AttilaFiel/Heating_Monitor_System/KiCad/HMS_Master/report.txt

Info: Processing symbol 'C1470µF/10V1:Capacitor_THT:CP_Radial_D8.0mm_P3.50mm'.
Info: Processing symbol 'C2100nF/50V1:Capacitor_THT:C_Disc_D3.8mm_W2.6mm_P2.50mm'.
Info: Processing symbol 'F1:Fuse:Fuseholder_Cylinder-5x20mm_Schurter_0031_8201_Horizontal_Open'.
Info: Processing symbol 'Q1:Package_TO_SOT_THT:TO-92_Inline'.
Info: Processing symbol 'R1:Resistor_THT:R_Axial_DIN0207_L6.3mm_D2.5mm_P7.62mm_Horizontal'.
Info: Processing symbol 'R2:Resistor_THT:R_Axial_DIN0207_L6.3mm_D2.5mm_P7.62mm_Horizontal'.
Info: Processing symbol 'R3:Resistor_THT:R_Axial_DIN0207_L6.3mm_D2.5mm_P7.62mm_Horizontal'.
Info: Processing symbol 'U1:HMS_Footprints:ESP32_DEVKITC_32UE'.
Info: Processing symbol 'U9:Connector_PinSocket_2.54mm:PinSocket_1x06_P2.54mm_Vertical'.
Info: Processing symbol 'U11:Connector_PinSocket_2.54mm:PinSocket_1x06_P2.54mm_Vertical'.
Info: Processing symbol 'U14:Connector_JST:JST_PH_B3B-PH-K_1x03_P2.00mm_Vertical'.
Info: Processing symbol 'U3:Connector_PinSocket_2.54mm:PinSocket_1x05_P2.54mm_Vertical'.
Info: Processing symbol 'U15:Connector_JST:JST_PH_B3B-PH-K_1x03_P2.00mm_Vertical'.
Info: Processing symbol 'U16:Connector_JST:JST_PH_B3B-PH-K_1x03_P2.00mm_Vertical'.
Info: Processing symbol 'U17:Connector_JST:JST_PH_B3B-PH-K_1x03_P2.00mm_Vertical'.
Info: Processing symbol 'U18:Connector_JST:JST_PH_B3B-PH-K_1x03_P2.00mm_Vertical'.
Info: Processing symbol 'U19:Connector_JST:JST_PH_B2B-PH-K_1x02_P2.00mm_Vertical'.
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
Error: U3 pad T+ not found in Connector_PinSocket_2.54mm:PinSocket_1x05_P2.54mm_Vertical.
Error: U3 pad T- not found in Connector_PinSocket_2.54mm:PinSocket_1x05_P2.54mm_Vertical.
Error: U9 pad SCL not found in Connector_PinSocket_2.54mm:PinSocket_1x06_P2.54mm_Vertical.
Error: U9 pad SDA not found in Connector_PinSocket_2.54mm:PinSocket_1x06_P2.54mm_Vertical.
Error: U9 pad VCC not found in Connector_PinSocket_2.54mm:PinSocket_1x06_P2.54mm_Vertical.
Error: U9 pad GND not found in Connector_PinSocket_2.54mm:PinSocket_1x06_P2.54mm_Vertical.
Error: U9 pad 32K not found in Connector_PinSocket_2.54mm:PinSocket_1x06_P2.54mm_Vertical.
Error: U9 pad SQW not found in Connector_PinSocket_2.54mm:PinSocket_1x06_P2.54mm_Vertical.
Error: U11 pad CS not found in Connector_PinSocket_2.54mm:PinSocket_1x06_P2.54mm_Vertical.
Error: U11 pad 3v3 not found in Connector_PinSocket_2.54mm:PinSocket_1x06_P2.54mm_Vertical.
Error: U11 pad GND not found in Connector_PinSocket_2.54mm:PinSocket_1x06_P2.54mm_Vertical.
Error: U11 pad MISO not found in Connector_PinSocket_2.54mm:PinSocket_1x06_P2.54mm_Vertical.
Error: U11 pad MOSI not found in Connector_PinSocket_2.54mm:PinSocket_1x06_P2.54mm_Vertical.
Error: U11 pad CLK not found in Connector_PinSocket_2.54mm:PinSocket_1x06_P2.54mm_Vertical.

Info: Total warnings: 55, errors: 55.
