AttilaFiel/Heating_Monitor_System/Documentation/HMS Documentation.docx

# Heating Monitor System (HMS)

# A projekt célja

2 kis gép építése fűtés rendszer megfigyelésére. Nem vezérlés a cél, de nyitva hagyom az opciót ha minden nagyon jól megy. Az eddigi biztos eszközök végeznek mindent.

A két ESP32-nek a mérés, megfigyelés, logolás és biztonsági figyelmeztetés lesz a feladatuk.

# Jelenlegi fűtés rendszer

1 vegyestüzelésű (fával fűtve) és 1 gázkazán van a rendszeren. Mindkettőnek saját keringetője van. Mindkettő előtt és után van egy golyós csap. Egy csap mindig el van zárva, attól függően melyik megy. Ha egyikről át kell állni a másikra akkor legalább az egyik csapot el kell zárni és megnyitni a másikon azt ami el van zárva. Így oldható meg, hogy egyik keringető sem keringeti a vizet a másik kazán rendszerén keresztül.

2 csőtermosztát van.

Az egyik akkor kapcsolja a vegyes tüzelésű kazán keringetőjét amikor be van gyújtva és az előremenő ág elkezd melegedni.

A másik a gázkazán visszatérő ágán van. Ez csak biztonsági feladatot lát el. Ha túlmelegszik a víz akkor lekapcsolja az gázkazán teljes áramellátását, megakadályozva a túlmelegedést, felforrást.

# Project előtti fejlesztés

1-1 golyós szelep felszerelése 230V szervomotorral.

A csőtermosztát úgy lesz bekötve, hogy a vegyestüzelésű kazán előremenő ágán, hogy a beállított hőmérséklet alatt kinyitja a gázkazán szelepét, elzárja a vegyestüzelésű kazán szelepét és áramot ad a gázkazán keringetőjének (a keringető nélkül nem folyik a gáz sem, tehát nem is tud beindulni a gázfűtés a termosztáttól függetlenül).

A beállított hőmérséklet felett kinyitja a vegyestüzelésű kazán szelepét, elzárja a gázkazán szelepét és áramot ad a vegyestüzelésű kazán keringetőjének.

Ennek a célja, hogy automatikusan átálljon gázra a rendszer ha kialudt a tűz és lehűlt a ház.

# ESP32 project

2 db ESP32. Az egyik a monitorozást és logolást végzi a kazánházban. A másik a hálószobában mutatja a mért értékeket.

A két ESP32 vezeték nélkül, wifi hálózaton kommunikál.

Veszély vagy bizonyos mért értékek esetén figyelmeztetést vagy riasztást ad (főleg az éjszakai vegyesről gázra való átállás a kritikus).

Jövőbeli project: icinga vagy nagios szerver az openwrt routeren vagy ubuntu laptopon ami összegyűjti a mért értékeket, logokat. Android appban folyamatos monitorozás.

## HMS-Master (kazánház)

Feladata a csatolt érzékelők olvasása, logolása és kijelzése

### Vezérlő:

1 db ESP32_DEVKITC_32UE https://www.hestore.hu/prod_10049537.html 100.495.37

### Kijelző:

2 db D096-12864-SPI7 kijelző https://www.hestore.hu/prod_10047949.html 100.479.49

### Hőmérséklet:

5 db DS18B20 hőmérő https://www.hestore.hu/prod_10035575.html 100.355.75

-Gázkazán előremenő cső külső hőmérséklet

-Gázkazán visszatérő cső külső hőmérséklet

-Vegyestüzelésű előremenő cső külső hőmérséklet

-Vegyestüzelésű visszatérő cső külső hőmérséklet

-Vegyestüzelésű kazán belső vízhőmérséklet merülőhüvellyel

1 db MAX6675 füstgáz hőmérő https://www.hestore.hu/prod_10040648.html 100.406.48

1 db DHT11 hőmérséklet érzékelő kazánház hőmérő

### Hálózati feszültség jelenlét érzékelő:

2 db MVPDM a vezérlő csőtermosztát 2 lábának feszültség érzékelése https://www.hestore.hu/prod_10044455.html 100.444.55

### Idő:

1 db DS3231+AT24C32 RTCM pontos óra https://www.hestore.hu/prod_10038042.html 100.380.42

### Tárolás:

1 db MICROSD-MODULE log tárolása https://www.hestore.hu/prod_10042087.html 100.420.87

### Hang:

1 db AKTÍV BUZZER riasztás

### LED:

1 db SERVO16-1A-SLD ledvezérlő https://www.hestore.hu/prod_10046486.html 100.464.86

3 db RKGB LED

### Táp:

1 db Adapter KS 5V/2A/USB

### egyéb elemek:

Biztosíték foglalat, biztosíték, ellenállás, kondenzátor stb

Feladata a mérés, mért adatok rögzítése, logolása, adatok rendelkezésre bocsátása a HMS-Displaynek, adatok kijelzése a kijelzőn.

Kijelzőn lévő adatok attól függnek, hogy melyik fűtési kör aktív, esetleg folyamatosan váltakozva mutatja az adatokat.

A Master egy nagyobb kapcsoló doboz része lesz ahol a 230V vezetékek fognak összefutni (csőtermosztát, keringetők, szelep motorok). Így lehetőség lesz különböző ledek használatára a kapcsolók mellett.

## HMS-Display (hálószoba)

Feladata a mért adatok kiolvasása a Masterről, figyelmeztetések és riasztások adása, a mért adatok kijelzése, hasonlóan a Master kijelzőjéhez.

A figyelmeztetések és riasztások a mért adatoktól függnek.

A legnagyobb probléma ha esetleg valamiért a gázkazán megy úgy, hogy ég a tűz a vegyesben. Erre kell a feszültség jelenlét érzékelő és a MAX6675 a füstgáz hőmérséklet érzékelésre.

A kisebb probléma ha lehűl a vegyes előremenő cső de mégsem kapcsol át a rendszer gázra.

A különböző problémákat különböző jelzések jelzik.

## Kijelzők

Fontos információk, állapotok kijelzése.

Jelző LED-ek egészítik ki a képernyőket

A vegyesnél a kazán belső vízhőmérséklete, a gáznál a visszatérő ág hőmérséklete a legfontosabb.

## Indikátor ledek

Mutatják, hogy melyik kör aktív.

Különösen fontos adatok kijelzése zöld/sárga/piros ledekkel, hogy milyen tartományban vannak, így egy pillanat alatt megállapítható, hogy minden rendben az adatok leolvasása nélkül.

Egy LED mutatja az ESP rendszer állapotát.

# Teljes rendszer funkció blokkvázlat

Fűtési rendszer

Vegyes kazán

Gázkazán

Csőtermosztátok

Keringetők

Motoros szelepek

HMS-Master ESP32

Mérés

Logolás

Kiértékelés

Helyi kijelzés

Riasztás

Wi-Fi kommunikáció

HMS-Display ESP32

Kijelzés

Hangjelzés

Riasztás

Jövőbeni szerver

(OpenWRT/Ubuntu)

Loggyűjtés

Grafikonok

Android elérés

Érzékelők

Wi-fi hálózat

# HMS-Master belső blokkvázlata

ESP32 Master

DS18B20 5db hőmérséklet érzékelő

MAX6675 füstgáz hőmérséklet érzékelő

230 V érzékelők 2 db

RTC+EEPROM DS3231 valós idejű óra

microSD Naplózás

OLED kijelző

LED-ek/Buzzer

Wi-Fi kapcsolat

# HMS-Display belső blokkvázlata

ESP32 Display

OLED kijelző

LED-ek/Buzzer

# Szoftver

## Blokkvázlat

Sensor Manager

Data Manager

Display

Network

Logger(SD)

Alarm Manager

Configuration

(EEPROM/Preferences)

Sensor

Alarm

Display

Network

## PlatformIO

src

include

lib

docs

hardware

schematics

pcb

# GPIO kiosztás

GPIO23 21 SPI_MOSI

GPIO19 27 SPI_MISO

GPIO18 28 SPI_SCK

GPIO22 22 I2C_SCL

GPIO21 25 I2C_SDA

GPIO27 11 TEMPERATURE_SENSOR_BUS (5× DS18B20)

GPIO26 10 BOILER_ROOM_TEMPERATURE (DHT11)

GPIO17 30 DISPLAY1_DC + DISPLAY2_DC

GPIO16 31 DISPLAY1_RESET + DISPLAY2_RESET

GPIO5 29 DISPLAY1_CS

GPIO13 15 DISPLAY2_CS

GPIO4 32 CHIMNEY_TEMPERATURE_CS (MAX6675)

GPIO25 9 BUZZER

GPIO32 7 GAS_AC_PRESENT

GPIO14 12 WOOD_AC_PRESENT

GPIO33 8 MICROSD_CS

## Buszok

### SPI

SPI_MOSI

SPI_MISO

SPI_SCK

DISPLAY1_CS

DISPLAY2_CS

DISPLAY_DC

DISPLAY_RESET

CHIMNEY_TEMPERATURE_CS

### I²C

I2C_SDA

I2C_SCL

Eszközök:

- DS3231 RTC
- SERVO16-1A-SLD (LED vezérlő)
- (később bármilyen I²C érzékelő)

### 1-Wire

TEMPERATURE_SENSOR_BUS

Érzékelők:

- GAS_FLOW_TEMPERATURE
- GAS_RETURN_TEMPERATURE
- WOOD_FLOW_TEMPERATURE
- WOOD_RETURN_TEMPERATURE
- WOOD_BOILER_TEMPERATURE

# KiCad

## Tervezési alapelvek

- Moduláris felépítés
- Minden érzékelő cserélhető csatlakozóval
- Modulok foglalatban
- Saját footprint minden modulhoz
- 230 V és kisfeszültség fizikailag elkülönítve
- Saját sheet minden funkcióhoz
- Buszrendszerek használata (SPI, I²C, OneWire)

## Sheet struktúra

Root sheet

- 01_ESP32
- 02_Power_Supply
- 03_Display
- 04_Chimney_Temperature
- 05_Temperature_Sensors
- 06_RTC
- 07_Buzzer
- 08_Boiler_Room_Sensor
- 09_MicroSD
- 10_Voltage_Detectors
- 11_LEDs

## LED állapotok

### Gázkazán

Zöld | Aktív gáz üzem, minden rendben
Piros | Ha mindkét ág aktív (ALARM_CRITICAL, ALARM_REASON_BOTH_BRANCHES)

### Vegyestüzelésű kazán

Zöld | Aktív fa üzem, minden rendben
Narancssárga | - Magas hőmérséklet (ALARM_WARNING, ALARM_REASON_WOOD_BOILER_WARNING) vagy - Startup warning (ALARM_WARNING, ALARM_REASON_STARTUP_WARNING)
Piros | - Ha mindkét ág aktív (ALARM_CRITICAL, ALARM_REASON_BOTH_BRANCHES) vagy - Tűzérzékelés kikapcsolt keringetők mellett, vagyis egyik AC érzékelő sem érzékel áramot (ALARM_CRITICAL, ALARM_REASON_FIRE_WITHOUT_CIRCULATOR) vagy - Túlmelegedés (ALARM_CRITICAL, ALARM_REASON_WOOD_BOILER_OVERHEAT) vagy - Sikertelen startup (ALARM_CRITICAL, ALARM_REASON_STARTUP_FAULT)
Kék | Aktív de nincs tűz (például fűtésciklus végém, amikor normálisan kialszik)

### Vezérlő állapot

Zöld | Minden rendben
Narancssárga | bármi warning
Piros | bármi critical
Kék | startup, frissítés
Lila | SD mentés/kommunikáció

# Riasztások:

Esemény | Hang | LED | Display

# Adatnaplózás specifikáció

## Naplózási rendszer célja

A Heating Monitor System (HMS) két külön naplófájlt használ:

1. Eseménynapló – a rendszer működésének és állapotváltozásainak rögzítésére.
2. Mérési napló – a szenzorok aktuális értékeinek időszakos rögzítésére.

A naplózás célja elsősorban a rendszer működésének utólagos visszakövetése és a hibák diagnosztizálása.

Az eseménynaplóban nem történik folyamatos, ciklusonkénti rögzítés. Az események csak akkor kerülnek be, amikor ténylegesen bekövetkeznek vagy megváltoznak.

## Fájlok és könyvtárstruktúra

A két naplófájl:

events.csv

measurements.csv

A könyvtárstruktúra:

/log/2026/09/events.csv

/log/2026/09/measurements.csv

A naplók hónaponként külön könyvtárba kerülnek.

## Eseménynapló formátuma

Az eseménynapló CSV formátumú.

Fejléc:

timestamp,type,event,value_old,value_new

Az value_old és value_new mezőket állapotváltozásoknál használjuk.

Eseményeknél, ahol nincs értelmezhető régi/új érték, a mezők üresen maradhatnak.

## Naplózott adatok:

### 1. SYSTEM – rendszerállapot változása

A systemData.systemState változásait naplózzuk.

Lehetséges értékek:

OFF

GAS

WOOD

FIRE_WITHOUT_CIRCULATOR

STARTUP

FAULT

Példa:

SYSTEM,STATE,GAS,STARTUP

SYSTEM,STATE,STARTUP,WOOD

SYSTEM,STATE,WOOD,OFF

Nincs külön eseménytípus minden egyes átmenetre.

### 2. BRANCH – aktív fűtési ág változása

Az activeBranch változásait naplózzuk.

Lehetséges értékek:

NONE

GAS

WOOD

ERROR

Példa:

BRANCH,STATE,NONE,GAS

BRANCH,STATE,GAS,WOOD

BRANCH,STATE,WOOD,NONE

### 3. ALARM – riasztási szint változása

Az alarmState minden változását naplózzuk.

Lehetséges értékek:

NONE

WARNING

CRITICAL

Példa:

ALARM,STATE,NONE,WARNING

ALARM,STATE,WARNING,CRITICAL

ALARM,STATE,CRITICAL,WARNING

ALARM,STATE,WARNING,NONE

Az ALARM logból csak a riasztási szint változása látszik. A riasztás konkrét okát az egyéb eseményekből lehet meghatározni.

### 4. FIRE – tűz jelenléte

A firePresent változásait naplózzuk.

Lehetséges állapotok:

OFF

ON

Példa:

FIRE,STATE,OFF,ON

FIRE,STATE,ON,OFF

A tűz jelenlétét a kéményhőmérséklet alapján határozzuk meg.

### 5. GAS_AC – gázág AC jelenléte

A gázág AC jelenlétének minden változását naplózzuk.

GAS_AC,STATE,OFF,ON

GAS_AC,STATE,ON,OFF

Az esemény külön naplózása akkor is megmarad, ha az aktív ág (BRANCH) logból részben következtetni lehetne rá.

A cél a részletesebb hibakeresés.

### 6. WOOD_AC – vegyes tüzelésű ág AC jelenléte

A vegyes tüzelésű ág AC jelenlétének minden változását naplózzuk.

WOOD_AC,STATE,OFF,ON

WOOD_AC,STATE,ON,OFF

Az AC állapotok külön logolása szándékosan megmarad, mert az SD-kártya kapacitása miatt a kissé redundánsabb, részletesebb naplózás előnyösebb, mint az esetleg hiányzó információ.

### 7. STARTUP – begyújtási folyamat

A startup eseményeknél nem kizárólag állapotváltozásokat naplózunk, hanem a folyamat fontos lépéseit is.

#### 7.1. START

A begyújtási folyamat elindul:

STARTUP,START

#### 7.2. FLOW_THRESHOLD

A fa/vegyes ág előremenő hőmérséklete átlépi a startup küszöbértékét.

Mindkét irányú átlépést naplózzuk:

STARTUP,FLOW_THRESHOLD,BELOW,ABOVE

STARTUP,FLOW_THRESHOLD,ABOVE,BELOW

Ez lehetővé teszi annak későbbi vizsgálatát, hogy az előremenő hőmérséklet hogyan viselkedett a keringető bekapcsolása után.

#### 7.3. SUCCESS

A startup sikeresen befejeződik, mert a vegyes tüzelésű ág AC-je bekapcsol:

STARTUP,SUCCESS

#### 7.4. FIRE_LOST

A startup folyamat közben a tűz kialszik:

STARTUP,FIRE_LOST

Ez warningot eredményez, nem critical hibát.

#### 7.5. TIMEOUT

A teljes startup folyamat időkorlátja lejár, mielőtt sikeres átkapcsolás történne:

STARTUP,TIMEOUT

Ez kritikus hibát eredményez.

#### 7.6. SWITCH_TIMER_START

A fa/vegyes előremenő eléri a startup küszöbértékét, ezért elindul az AC átkapcsolására váró időzítő:

STARTUP,SWITCH_TIMER_START

Az eseményt azért naplózzuk külön, mert fontos látni a timer tényleges működését.

#### 7.7. SWITCH_TIMER_STOP

Az időzítő normál módon leáll.

Sikeres átkapcsolás esetén:

STARTUP,SWITCH_TIMER_STOP,SUCCESS

A tűz kialvása esetén:

STARTUP,SWITCH_TIMER_STOP,FIRE_LOST

#### 7.8. SWITCH_TIMER_TIMEOUT

Az AC átkapcsolására váró időzítő lejár:

STARTUP,SWITCH_TIMER_TIMEOUT

Ez kritikus hibát aktivál.

A timer események célja, hogy a startup folyamat időzítésének teljes lefutása utólag látható legyen.

#### 7.9. OVERHEAT – kazán túlmelegedés

A kazán hőmérsékletének túlmelegedési állapotváltozásait külön naplózzuk.

A szintek:

NORMAL

WARNING

CRITICAL

Küszöbértékek:

< 70 °C NORMAL

70–79,9 °C WARNING

≥ 80 °C CRITICAL

Lehetséges állapotátmenetek:

OVERHEAT,STATE,NORMAL,WARNING

OVERHEAT,STATE,WARNING,CRITICAL

OVERHEAT,STATE,CRITICAL,WARNING

OVERHEAT,STATE,WARNING,NORMAL

OVERHEAT,STATE,CRITICAL,NORMAL

Ha a mérések között a hőmérséklet közvetlenül CRITICAL értékről NORMAL értékre kerül, nem hozunk létre mesterséges köztes WARNING eseményt.

Az OVERHEAT és az ALARM esemény egyszerre is megjelenhet a logban.

Ez szándékos:

- OVERHEAT → a kazán túlmelegedési állapotának változása
- ALARM → a riasztási logika eredménye

A konkrét hőmérsékleti érték nem kerül külön az eseménynaplóba, mert az a mérési naplóban megtalálható.

### 8. ESP32 – vezérlő eseményei

Az ESP32 saját működésével kapcsolatos fontos eseményeket naplózzuk.

#### 8.1. BOOT

Az ESP32 elindulása:

ESP32,BOOT

#### 8.2. RESET

Az ESP32 újraindulása a rendelkezésre álló reset okkal együtt:

ESP32,RESET,<reason>

A reset okát minden rendelkezésre álló esetben naplózzuk.

Példák:

ESP32,RESET,POWER_ON

ESP32,RESET,SOFTWARE

ESP32,RESET,WATCHDOG

ESP32,RESET,BROWNOUT

ESP32,RESET,UNKNOWN

A RESET és BOOT eseményeket egyaránt naplózzuk.

#### 8.3. WIFI_CONNECTED

WiFi-kapcsolat létrejötte:

ESP32,WIFI_CONNECTED

#### 8.4. WIFI_DISCONNECTED

WiFi-kapcsolat megszakadása:

ESP32,WIFI_DISCONNECTED

A WiFi események különösen fontosak a hálózati lefedettség és az alkalmazott külső antenna megoldásának vizsgálatához.

#### 8.5. ERROR

Általános ESP32-oldali hiba:

ESP32,ERROR,<reason>

A kategória előre be van tervezve, akkor is, ha jelenleg nincs konkrét felhasználási esete.

### 9. RTC – valós idejű óra eseményei

Az RTC hibáit és helyreállását naplózzuk.

#### 9.1. ERROR

RTC,ERROR,<reason>

Lehetséges okok:

NOT_FOUND

READ_ERROR

INVALID_TIME

OSCILLATOR_STOP

#### 9.2. INVALID_TIME

Az RTC időpontja érvénytelen, ha:

timestamp < 2000.01.01 00:00:00

A 2000.01.01 00:00:00 önmagában még érvényes időpont.

#### 9.3. OSCILLATOR_STOP

A DS3231 oscillator stop flag jelzi, hogy az RTC oszcillátora korábban leállt:

RTC,ERROR,OSCILLATOR_STOP

#### 9.4. RECOVERED

Ha egy korábbi RTC-hiba után az RTC ismét megfelelően működik:

RTC,RECOVERED

Az RTC hibák WARNING szintűek, nem CRITICAL hibák.

### 10. SD – SD-kártya eseményei

Az SD-kártyával kapcsolatos fontos működési és hibajelenségeket naplózzuk.

#### 10.1. MOUNT_OK

Az SD-kártya sikeresen inicializálódott és felcsatolható:

SD,MOUNT_OK

Ez minden bootkor hasznos információ.

#### 10.2. MOUNT_ERROR

Az SD inicializálása vagy használatba vétele nem sikerül:

SD,MOUNT_ERROR,<reason>

Lehetséges okok:

REMOVED

NOT_FOUND

INIT_ERROR

A kártya eltávolítását nem külön eseményként kezeljük, hanem:

SD,MOUNT_ERROR,REMOVED

formában naplózzuk.

#### 10.3. WRITE_ERROR

Az SD-re történő írás sikertelen:

SD,WRITE_ERROR,<reason>

A reason megadhatja például, hogy melyik napló írása hibázott:

EVENT_LOG

MEASUREMENT_LOG

#### 10.4. FULL

Az SD-kártyán nincs elegendő szabad hely:

SD,FULL

#### 10.5. RECOVERED

Korábbi SD-hiba után az SD-kártya ismét működőképes:

SD,RECOVERED

Az SD-hibák WARNING szintűek, nem CRITICAL hibák.

## Mérési napló

A mérési napló nem eseményalapú, hanem percenként egy mérést rögzít.

Fejléc:

timestamp,gasFlow,gasReturn,woodFlow,woodReturn,woodBoiler,chimney,roomTemp,humidity,gasAC,woodAC

A naplózott adatok:

- gáz előremenő hőmérséklet
- gáz visszatérő hőmérséklet
- vegyes előremenő hőmérséklet
- vegyes visszatérő hőmérséklet
- vegyes kazán hőmérséklet
- kéményhőmérséklet
- kazánházi/szoba hőmérséklet
- páratartalom
- gáz AC állapot
- vegyes AC állapot

A konkrét hőmérsékleti értékek tehát nem kerülnek feleslegesen az eseménynaplóba.

## Várható fájlméret

A mérési log percenként készül:

- 30 nap → 43 200 mérési sor
- 31 nap → 44 640 mérési sor

A várható mérési log mérete körülbelül:

~4,3–5,8 MB / hónap

Az eseménynapló várhatóan csak töredéke ennek, jellemzően néhány száz KB alatt marad.

Tervezési tartalékkal:

~5–6 MB / hónap

~60–72 MB / év

Az SD-kártya kapacitása ezért a rendszer számára bőséges. A logolásnál nem szükséges a fájlméretet agresszíven optimalizálni; a részletesebb eseménynaplózás előnyösebb a későbbi hibakeresés szempontjából.

## Naplózási alapelv

Az eseménynapló alapelve:

Ami állapotváltozás, azt változásként naplózzuk. Ami folyamat vagy egyszeri esemény, azt eseményként naplózzuk.

Nem cél minden programciklus vagy minden mérés eseménynaplózása.

A részletes működési állapotot a két napló együtt adja:

- events.csv → mi történt és mikor
- measurements.csv → milyen mérési értékek mellett történt

Ez lehetővé teszi például egy startup, túlmelegedés, WiFi-szakadás vagy SD/RTC-hiba teljes utólagos elemzését.

# Mechanika

Doboz

rögzítés

kábelbevezetés

kijelző

szellőzés

230 V

ESP32 antenna

## Vezetékezés

- Belső vezetékek UTP erek. Átmérő 0,51 mm, AWG24, keresztmetszet 0,205 mm²
- 3V3, GND gerincek keresztmetszet 0,75 mm² tömör réz vezeték, átmérője kb. 0,98 mm, majdnem pontosan AWG18. Alternatíva 0,5 mm² tömör réz, átmérő kb. 0,8 mm, nagyjából AWG20
- Külső vezeték sértetlen UTP kábel

# Döntés napló

Dátum | Döntés | Indok
2026.08.03 | 33Ω ellenállás elhelyezése a DS18B20 cső hőmérők közös adatlábán (OneWire) | Előfordulhat, hogy kell az ellenállás. Előre tervezés szempontjából érdemes vagy egy 0Ω ellenállást betenni, ha tényleg van zaj, akkor egy 33Ω ellenállást. Viszont nyugodtan mehet a 33Ω ellenállás, nem kell megvárni, hogy zajos-e. Ha nincs rá szükség akkor sincs következménye.
2026.08.07 | Két kijelző a HMS-Masteren | Túl kicsik az elsőre rendelt kijelzők. Ezért mindkettőt a HMS-Masterbe teszem és rendeltem egy jóval nagyobbat a HMS-Displaybe
2026.08.07 | SERVO16-1A-SLD PCA9685 rendelése | az RKGB ledek ne a GPIO lábakat foglalják
2026.08.07 | Cat5e UTP használat a vezetékezésre | A külső szenzorokat Cat5e vezetékkel fogom bekötni. A sodort érpárok jó zaj ellen, szigetelt, erős
2026.08.08 | A cső hőmérséklet mérésére a 4 db DS18B20 1 db UTP vezeték fog vezetni az elágazásig, 3 eret használva | Korábbi tervezés szerint az UTP 6 erét használtam volna a szenzorokig. E helyett csak 3 eret használok és a szenzorokhoz közel fog elágazni. Így kisebbek az ágak, hosszabb a OneWire és kisebb a zaj és visszhang esélye.
2026.08.17 | Elosztó doboz, DIN sín, sorkapocs | 20x30x13 doboz lett kiválasztva. A kazánház 230V összeköttetései DIN sínre szerelhető WAGO sorkapcsok lesznek.
2026.08.27 | Kijelzőkön megjelenő adat | Display 1: Aktív ág (AC jelenlét), Előremenő vízhőmérséklet vagy kazán hőmérséklet Display 2: Aktív ág előremenő, aktív ák visszatérő, füstgáz hőmérséklet, kazánház hömérséklet és páratartalom, pontos dátum és idő
2026.09.04 | Teljes naplózás kidolgozása

# Jóvőbeli bővítések

Grafikon

Android

OTA vezeték nélküli szoftverfrissítést (Over-the-Air)

MQTT?

Icinga/Nagios

Web

Relék

# TODO:

## Eldönteni a backupot.

Kazánban UPS.

Kialakítani egy 5 V / GND tápcsatlakozást a backup rendszernek?

## Fogyasztás mérés:

Amikor elkészül a panel, egy multiméterrel ténylegesen megmérhetjük a HMS-Master teljes fogyasztását:

- nyugalomban,
- Wi-Fi kommunikáció közben,
- SD-írás közben,
- kijelzők bekapcsolva,
- mindhárom RGB LED teljes fehérben,
- buzzer bekapcsolva.

Ebből pedig megkapjuk a valós minimum / átlag / maximum áramot, és akkor véglegesen eldönthetjük, hogy a T1A biztosíték és az AWG24-es, párhuzamosított 5 V/GND vezetékek megfelelőek-e.

### Egyéb programozási feladatok:

szenzorhibák központi kezelése és riasztása

### 5. Webes aktuális állapot

Ez már egy nagyon érdekes következő funkció lenne.

Például:

HMS

Gáz: BE

Fa: KI

Tűz: VAN

Fa kazán: 67.3 °C

Fa előre: 61.2 °C

Fa vissza: 54.8 °C

Kémény: 143 °C

Állapot: FA FŰTÉS

Riasztás: NINCS

Ez azért jó, mert akkor telefonról/laptopról nem csak a logokat tudod letölteni, hanem látod az aktuális rendszert is.

## Motoros szelepek:

https://www.emag.hu/2-utas-szelep-1-be-ki-szervomotorral-220v-50hz-daver-dvr-hy4016-21/pd/D4FS2TYBM/

https://www.emag.hu/daver-2-utas-forgoszelep-1-gyors-szervomotorral-230v-50hz-automatikus-kezi-vezerlessel-dvr-hl-2102/pd/DJD7CBYBM/

https://www.emag.hu/daver-2-utas-forgoszelep-1-gyors-szervomotorral-automatikus-kezi-vezerlessel-es-230v-50hz-relevel-dvr-hl-2102rlu/pd/D4D7CBYBM/

https://www.emag.hu/ketutas-on-off-elektromos-szelep-1-220v-50hz-rugos-visszaterito-mechanizmussal-daver-dvr-hy6016-21/pd/D1FLD53BM/

watchdog: Ha valamiért lefagyna az ESP32, 30 másodperc múlva újraindul.
