AttilaFiel/Heating_Monitor_System/Documentation/Datasheets/MICROSD-MODULE_EN_10042087.png

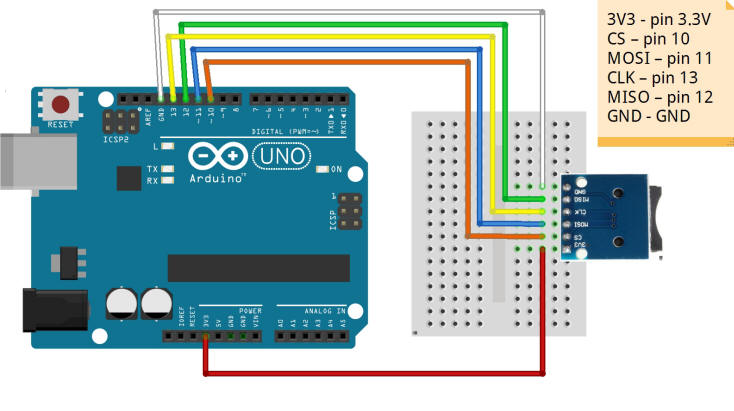
Documentation/Datasheets/MICROSD-MODULE_EN_10042087.png
