AttilaFiel/Heating_Monitor_System/KiCad/HMS_Master/HMS_Master.pdf

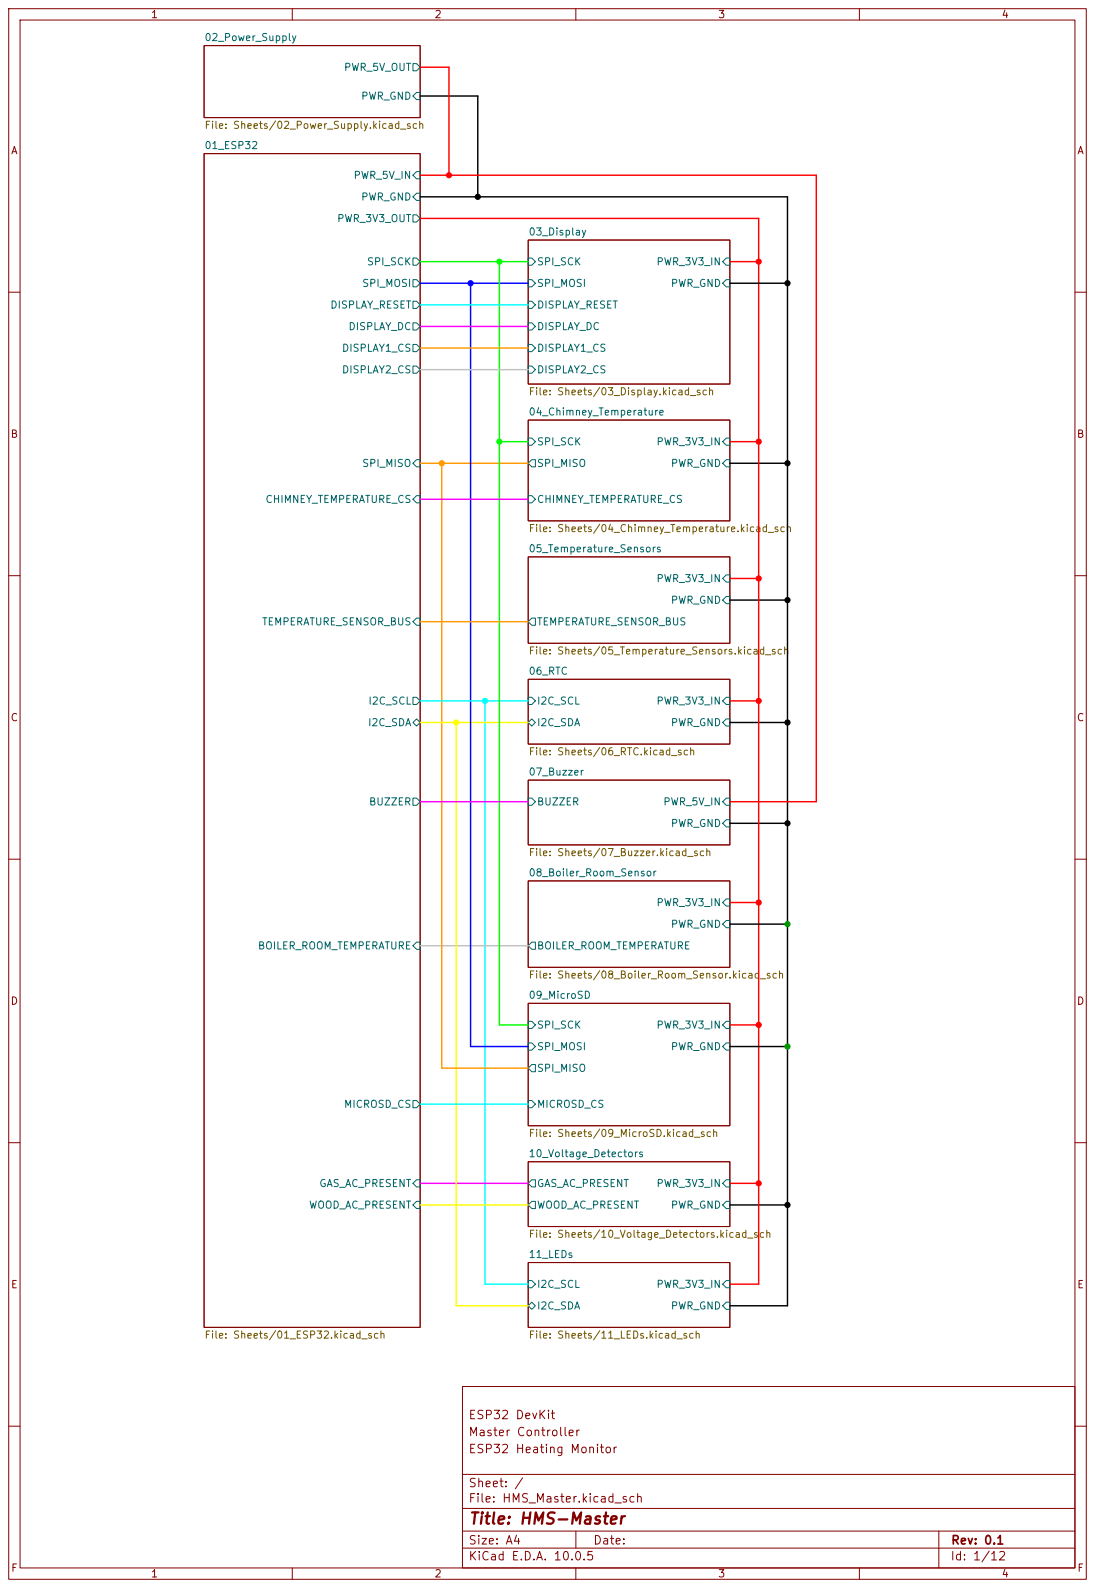
[picture p3: page 1]

Size: A4 | Rev: 0.1 | F Date:
KiCad E.D.A. 10.0.5 | Id: 1/12
