AttilaFiel/Heating_Monitor_System/KiCad/HMS_230V/HMS_230V.pdf

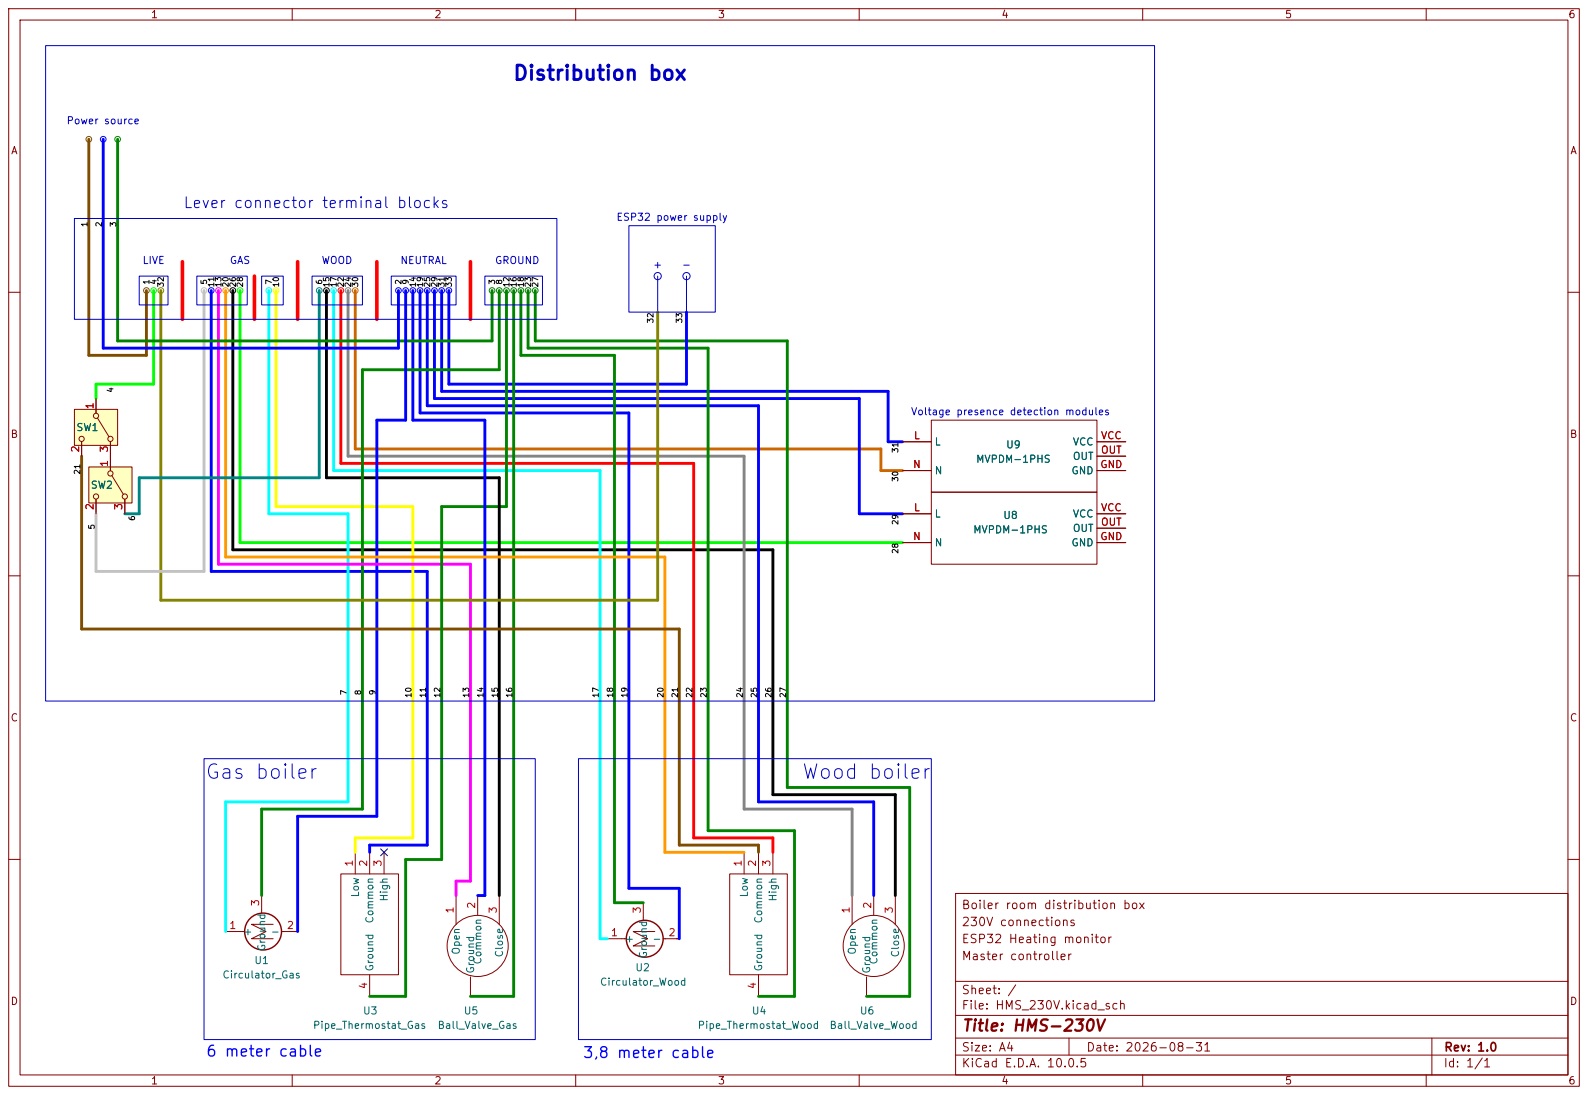
[picture p4: page 1]

81120335 WOOD 28 GAS 31 21 Power source

7 Lever connector terminal blocks 12 NEUTRAL 182163 GROUND 10

1 Common 2 High 3 Ground 4 U3 Pipe_Thermostat_Gas Ground Open 1 Common 2 Close 3 U6 Ball_Valve_Wood

Boiler room distribution box +
2 Ground 3 U2 Circulator_Wood

Size: A4 | Rev: 1.0
KiCad E.D.A. 10.0.5 | Id: 1/1
