AttilaFiel/Heating_Monitor_System/KiCad/HMS_Master/HMS_Master-PCB.pdf

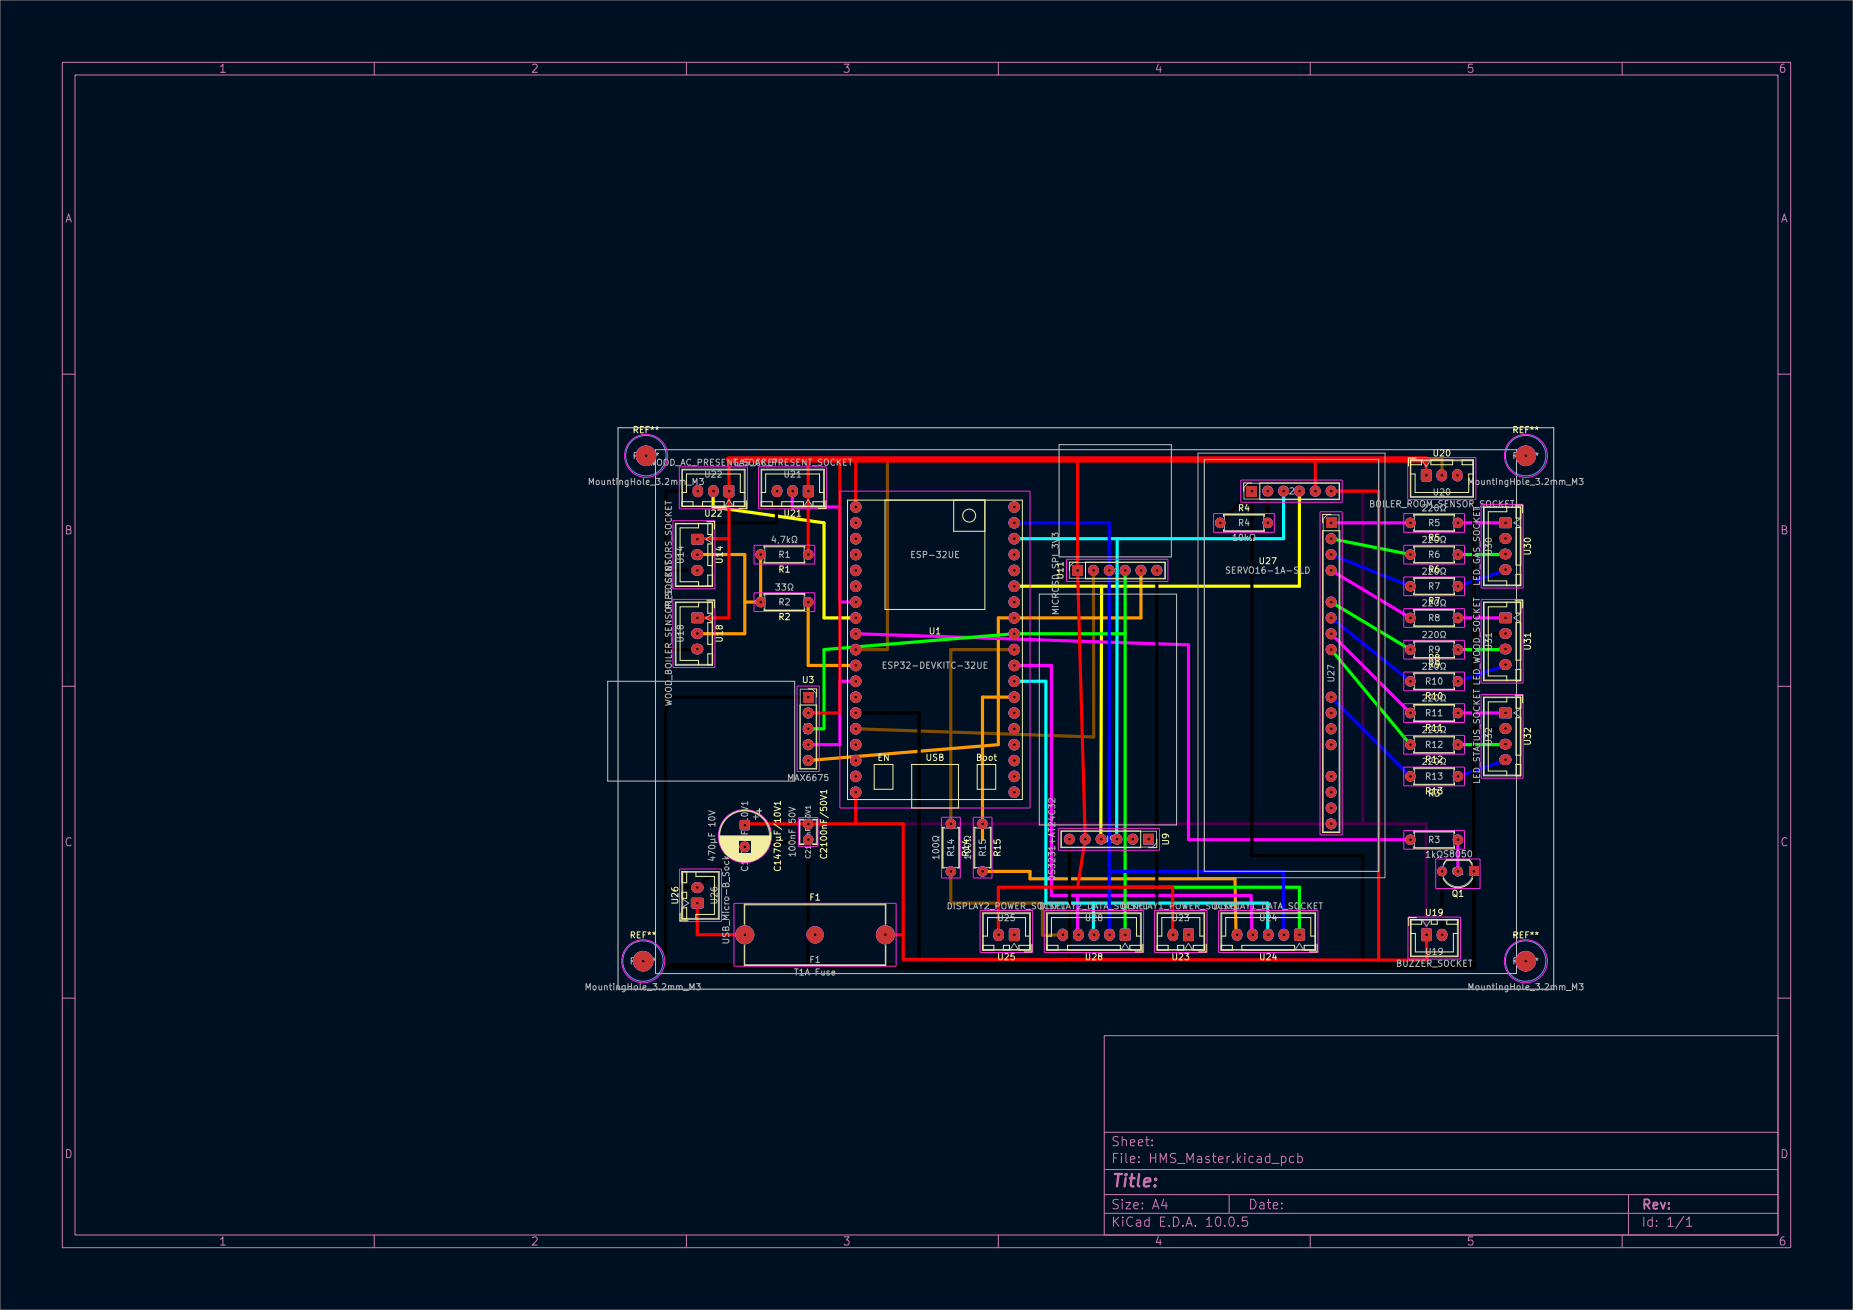
[picture p5: page 1]
