AttilaFiel/Heating_Monitor_System/KiCad/HMS_Display/HMS_Display.kicad_pcb

## KiCad design KiCad/HMS_Display/HMS_Display.kicad_pcb (2026-10-28)

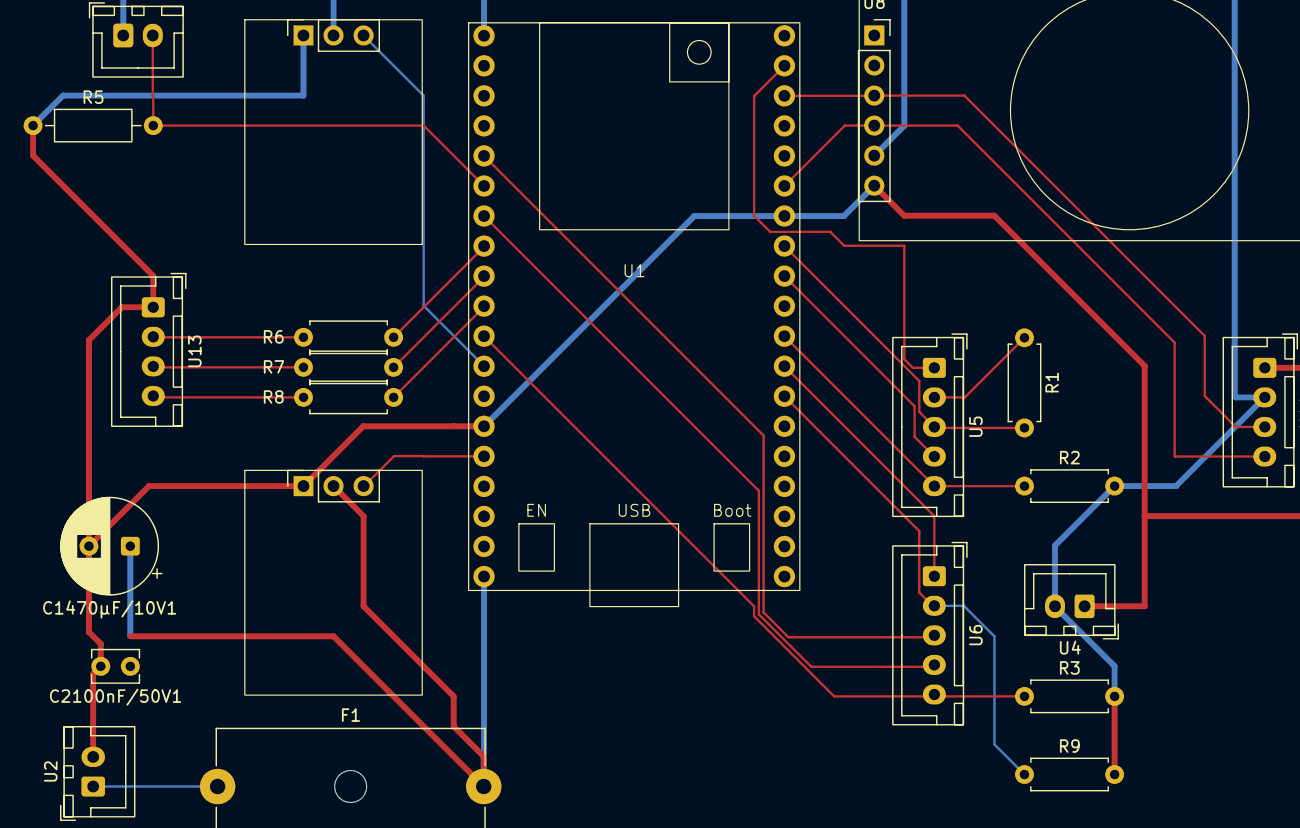
[picture p6: board HMS_Display.kicad_pcb from above]

Board: 2 copper layers, 22 parts (0 on the bottom side), 25 nets.

Parts:
C1470µF/10V1: 470µF 10V; CP_Radial_D8.0mm_P3.50mm
C2100nF/50V1: 100nF 50V; C_Disc_D3.8mm_W2.6mm_P2.50mm
F1: T1A Fuse; Fuseholder_Cylinder-5x20mm_Schurter_0031_8201_Horizontal_Op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
R1: DNP SOCKET; R_Axial_DIN0207_L6.3mm_D2.5mm_P7.62mm_Horizontal
R2, R3, R9: SOCKET; R_Axial_DIN0207_L6.3mm_D2.5mm_P7.62mm_Horizontal
R5: 10kΩ; R_Axial_DIN0207_L6.3mm_D2.5mm_P10.16mm_Horizontal
R6, R7, R8: 220Ω; R_Axial_DIN0207_L6.3mm_D2.5mm_P7.62mm_Horizontal
U1: ESP32-DEVKITC-32UE; ESP32_DEVKITC_32UE
U2: USB-C_POWER_CONNECTOR; JST_XH_B2B-XH-A_1x02_P2.50mm_Vertical
U4: DISPLAY_POWER_CONNECTOR; JST_XH_B2B-XH-A_1x02_P2.50mm_Vertical
U5: DISPLAY_DATA_CONNECTOR_1; JST_XH_B5B-XH-A_1x05_P2.50mm_Vertical
U6: DISPLAY_DATA_CONNECTOR_2; JST_XH_B5B-XH-A_1x05_P2.50mm_Vertical
U8: DS3231+AT24C32; PinSocket_1x06_P2.54mm_Vertical
U9, U10: KY-012
U11: SHT30_CONNECTOR; JST_XH_B4B-XH-A_1x04_P2.50mm_Vertical
U12: PHOTORESISTOR_CONNECTOR; JST_XH_B2B-XH-A_1x02_P2.50mm_Vertical
U13: LED_CONNECTOR; JST_XH_B4B-XH-A_1x04_P2.50mm_Vertical

Connections:
/01_ESP32/BUZZER_1: U1.12 (GPIO14), U9.3 (SIGNAL)
/01_ESP32/BUZZER_2: U1.15 (GPIO13), U10.3 (SIGNAL)
/01_ESP32/DISPLAY_CS: R2.1, U1.30 (GPIO17), U5.5
/01_ESP32/DISPLAY_DC: U1.31 (GPIO16), U6.1
/01_ESP32/DISPLAY_LED: U1.7 (GPIO32), U6.4
/01_ESP32/DISPLAY_RESET: R9.1, U1.32 (GPIO4), U6.2
/01_ESP32/I2C_SCL: U1.22 (GPIO22), U8.3 (SCL), U11.3
/01_ESP32/I2C_SDA: U1.25 (GPIO21), U8.4 (SDA), U11.4
/01_ESP32/LED_B: R8.1, U1.10 (GPIO26)
/01_ESP32/LED_G: R7.1, U1.9 (GPIO25)
/01_ESP32/LED_R: R6.1, U1.8 (GPIO33)
/01_ESP32/PHOTORESISTOR: R5.2, U1.6 (GPIO35), U12.2
/01_ESP32/PWR_3V3_OUT: R2.2, R3.2, R9.2, U1.1 (3V3), U4.2, U8.5 (VCC), U9.2 (VCC), U11.2, U12.1
/01_ESP32/PWR_5V_IN: C1470µF/10V1.1, C2100nF/50V1.1, F1.2, U1.19 (5V), U10.2 (VCC)
/01_ESP32/PWR_GND: C1470µF/10V1.2, C2100nF/50V1.2, R5.1, U1.14 (GND), U1.20 (GND), U1.26 (GND), U2.2, U4.1, U8.6 (GND), U9.1 (GRN), U10.1 (GRN), U11.1, U13.1
/01_ESP32/SPI_MISO: R1.2, U1.27 (GPIO19), U5.3
/01_ESP32/SPI_MOSI: U1.21 (GPIO23), U5.1
/01_ESP32/SPI_SCK: U1.28 (GPIO18), U5.4
/01_ESP32/T_CS: R3.1, U1.11 (GPIO27), U6.5
/01_ESP32/T_IRQ: U1.5 (GPIO34), U6.3
unnamed: F1.1, U2.1
unnamed: R1.1, U5.2
unnamed: R6.2, U13.2
unnamed: R7.2, U13.3
unnamed: R8.2, U13.4
