AttilaFiel/Heating_Monitor_System/KiCad/HMS_Master/HMS_Master.kicad_pcb

## KiCad design KiCad/HMS_Master/HMS_Master.kicad_pcb (2026-08-16)

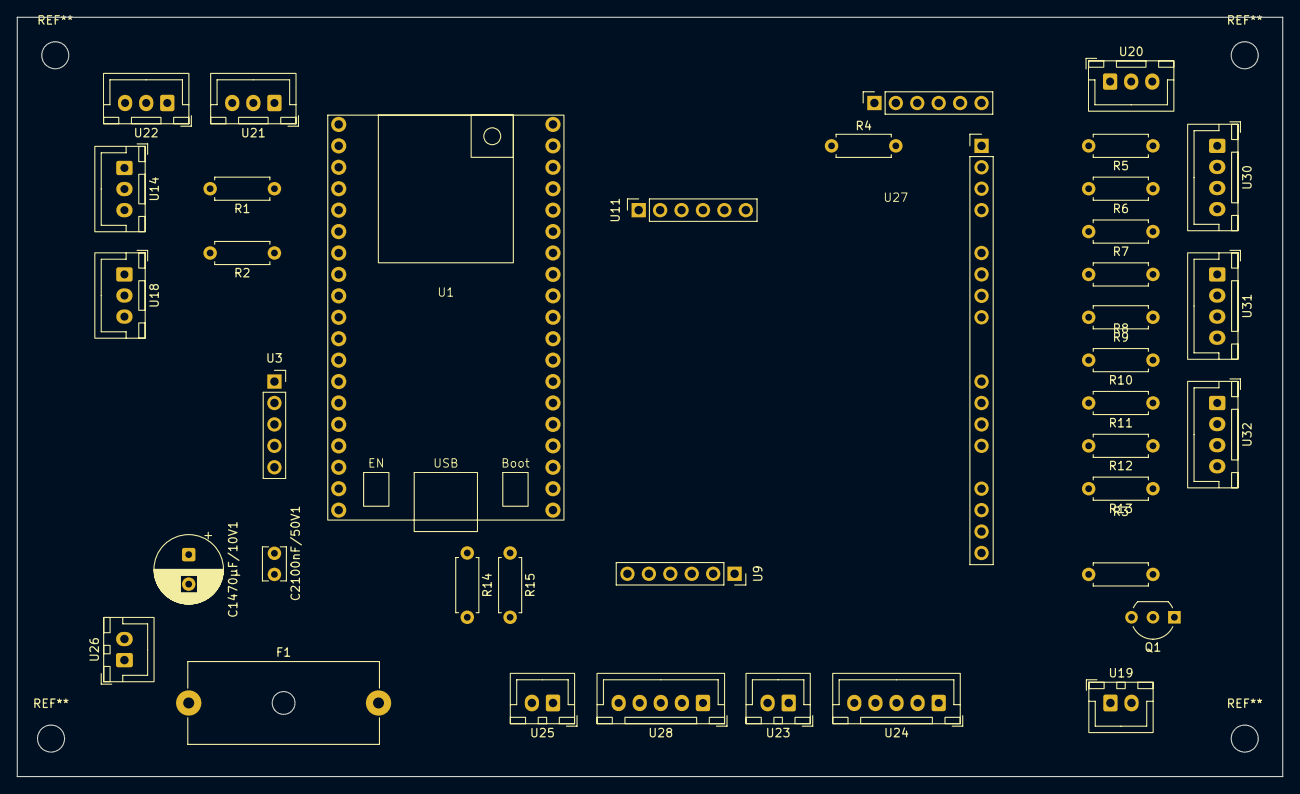
[picture p7: board HMS_Master.kicad_pcb from above]

Board: 2 copper layers, 150.0 x 90.0 mm, 38 parts (0 on the bottom side), 44 nets.

Parts:
C1470µF/10V1: 470µF 10V; CP_Radial_D8.0mm_P3.50mm
C2100nF/50V1: 100nF 50V; C_Disc_D3.8mm_W2.6mm_P2.50mm
F1: T1A Fuse; Fuseholder_Cylinder-5x20mm_Schurter_0031_8201_Horizontal_Op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
Q1: S8050; TO-92_Inline_Wide
R1: 4,7kΩ; R_Axial_DIN0207_L6.3mm_D2.5mm_P7.62mm_Horizontal
R2: 33Ω; R_Axial_DIN0207_L6.3mm_D2.5mm_P7.62mm_Horizontal
R3: 1kΩ; R_Axial_DIN0207_L6.3mm_D2.5mm_P7.62mm_Horizontal
R4: 10kΩ; R_Axial_DIN0207_L6.3mm_D2.5mm_P7.62mm_Horizontal
R5, R6, R7, R8, R9, R10, R11, R12, R13: 220Ω; R_Axial_DIN0207_L6.3mm_D2.5mm_P7.62mm_Horizontal
R14, R15: 100Ω; R_Axial_DIN0207_L6.3mm_D2.5mm_P7.62mm_Horizontal
U1: ESP32-DEVKITC-32UE; ESP32_DEVKITC_32UE
U3: MAX6675; PinSocket_1x05_P2.54mm_Vertical
U9: DS3231+AT24C32; PinSocket_1x06_P2.54mm_Vertical
U11: MICROSD_SPI_3V3; PinSocket_1x06_P2.54mm_Vertical
U14: PIPE_SENSORS_SOCKET; JST_XH_B3B-XH-A_1x03_P2.50mm_Vertical
U18: WOOD_BOILER_SENSOR_SOCKET; JST_XH_B3B-XH-A_1x03_P2.50mm_Vertical
U19: BUZZER_SOCKET; JST_XH_B2B-XH-A_1x02_P2.50mm_Vertical
U20: BOILER_ROOM_SENSOR_SOCKET; JST_XH_B3B-XH-A_1x03_P2.50mm_Vertical
U21: GAS_AC_PRESENT_SOCKET; JST_XH_B3B-XH-A_1x03_P2.50mm_Vertical
U22: WOOD_AC_PRESENT_SOCKET; JST_XH_B3B-XH-A_1x03_P2.50mm_Vertical
U23: DISPLAY1_POWER_SOCKET; JST_XH_B2B-XH-A_1x02_P2.50mm_Vertical
U24: DISPLAY1_DATA_SOCKET; JST_XH_B5B-XH-A_1x05_P2.50mm_Vertical
U25: DISPLAY2_POWER_SOCKET; JST_XH_B2B-XH-A_1x02_P2.50mm_Vertical
U26: USB_Micro-B_Socket; JST_XH_B2B-XH-A_1x02_P2.50mm_Vertical
U27: SERVO16-1A-SLD
U28: DISPLAY2_DATA_SOCKET; JST_XH_B5B-XH-A_1x05_P2.50mm_Vertical
U30: LED_GAS_SOCKET; JST_XH_B4B-XH-A_1x04_P2.50mm_Vertical
U31: LED_WOOD_SOCKET; JST_XH_B4B-XH-A_1x04_P2.50mm_Vertical
U32: LED_STATUS_SOCKET; JST_XH_B4B-XH-A_1x04_P2.50mm_Vertical

Connections:
/01_ESP32/BOILER_ROOM_TEMPERATURE: U1.10 (GPIO26), U20.2
/01_ESP32/BUZZER: R3.1, U1.9 (GPIO25)
/01_ESP32/CHIMNEY_TEMPERATURE_CS: U1.12 (GPIO14), U3.4 (CS)
/01_ESP32/DISPLAY1_CS: R14.1, U1.29 (GPIO5)
/01_ESP32/DISPLAY2_CS: R15.1, U1.32 (GPIO4)
/01_ESP32/DISPLAY_DC: U1.30 (GPIO17), U24.4, U28.4
/01_ESP32/DISPLAY_RESET: U1.31 (GPIO16), U24.3, U28.3
/01_ESP32/GAS_AC_PRESENT: U1.7 (GPIO32), U21.2
/01_ESP32/I2C_SCL: U1.22 (GPIO22), U9.3 (SCL), U27.3 (SCL)
/01_ESP32/I2C_SDA: U1.25 (GPIO21), U9.4 (SDA), U27.4 (SDA)
/01_ESP32/MICROSD_CS: U1.15 (GPIO13), U11.2 (CS)
/01_ESP32/PWR_3V3_OUT: R1.1, U1.1 (3V3), U3.2 (VCC), U9.5 (VCC), U11.1 (3v3), U14.1, U18.1, U20.1, U21.1, U22.1, U23.2, U25.2, U27.5 (VCC)
/01_ESP32/PWR_5V_IN: C1470µF/10V1.1, C2100nF/50V1.1, F1.2, U1.19 (5V), U19.1
/01_ESP32/PWR_GND: C1470µF/10V1.2, C2100nF/50V1.2, Q1.1 (E), R4.1, U1.14 (GND), U1.20 (GND), U1.26 (GND), U3.1 (GND), U9.6 (GND), U11.6 (GND), U14.3, U18.3, U20.3, U21.3, U22.3, U23.1, U25.1, U26.2, U27.1 (GND), U30.2, U31.2, U32.2
/01_ESP32/SPI_MISO: U1.27 (GPIO19), U3.5 (SO), U11.5 (MISO)
/01_ESP32/SPI_MOSI: U1.21 (GPIO23), U11.3 (MOSI), U24.2, U28.2
/01_ESP32/SPI_SCK: U1.28 (GPIO18), U3.3 (SCK), U11.4 (CLK), U24.1, U28.1
/01_ESP32/TEMPERATURE_SENSOR_BUS: R2.1, U1.11 (GPIO27)
/01_ESP32/WOOD_AC_PRESENT: U1.8 (GPIO33), U22.2
unnamed: F1.1, U26.1
unnamed: Q1.2 (B), R3.2
unnamed: Q1.3 (C), U19.2
unnamed: R1.2, R2.2, U14.2, U18.2
unnamed: R5.1, U30.1
unnamed: R6.1, U30.3
unnamed: R7.1, U30.4
unnamed: R8.1, U31.1
unnamed: R9.1, U31.3
unnamed: R10.1, U31.4
unnamed: R11.1, U32.1
unnamed: R12.1, U32.3
unnamed: R13.1, U32.4
unnamed: R14.2, U24.5
unnamed: R15.2, U28.5
unnamed: R4.2, U27.2 (OE)
unnamed: R5.2, U27.7 (PWM0)
unnamed: R6.2, U27.8 (PWM1)
unnamed: R7.2, U27.9 (PWM2)
unnamed: R8.2, U27.10 (PWM3)
unnamed: R9.2, U27.11 (PWM4)
unnamed: R10.2, U27.12 (PWM5)
unnamed: R11.2, U27.13 (PWM6)
unnamed: R12.2, U27.14 (PWM7)
unnamed: R13.2, U27.15 (PWM8)
