AttilaFiel/Heating_Monitor_System/Firmware/Master/Heating_Monitor_System/src/ds18b20.cpp

#include <Arduino.h>
#include <OneWire.h>
#include <DallasTemperature.h>

#include "config.h"
#include "network.h"
#include "ds18b20.h"


OneWire oneWire(TEMPERATURE_SENSOR_BUS);

DallasTemperature ds18b20(&oneWire);

struct SensorReadStats
{
    unsigned long firstReadError;
    unsigned long retrySuccess;
    unsigned long doubleError;
};

SensorReadStats gasFlowStats = {0, 0, 0};
SensorReadStats gasReturnStats = {0, 0, 0};
SensorReadStats woodFlowStats = {0, 0, 0};
SensorReadStats woodReturnStats = {0, 0, 0};
SensorReadStats woodBoilerStats = {0, 0, 0};

// Hexadecimális cím string átalakítása
// DS18B20 DeviceAddress formátumra
bool stringToAddress(const char* addressString, DeviceAddress address)
{
    if (strlen(addressString) != 16)
    {
        return false;
    }

    for (int i = 0; i < 8; i++)
    {
        char byteString[3];

        byteString[0] = addressString[i * 2];
        byteString[1] = addressString[i * 2 + 1];
        byteString[2] = '\0';

        address[i] = strtoul(byteString, nullptr, 16);
    }

    return true;
}


// Egyetlen DS18B20 kiolvasása
void readSensor(const char* sensorName, const char* sensorAddress)
{
    DeviceAddress address;

    char message[100];


    // Cím átalakítása
    if (!stringToAddress(sensorAddress, address))
    {
        snprintf(
            message,
            sizeof(message),
            "%s: HIBA - ervenytelen szenzor cim!",
            sensorName
        );

        logMessage(message);

        return;
    }


    // Ellenőrizzük, hogy a szenzor tényleg megtalálható-e
    if (!ds18b20.isConnected(address))
    {
        snprintf(
            message,
            sizeof(message),
            "%s: HIBA - szenzor nem talalhato!",
            sensorName
        );

        logMessage(message);

        return;
    }


    // Hőmérséklet kiolvasása
    float temperature = ds18b20.getTempC(address);


    // Hibás hőmérséklet ellenőrzése
    if (temperature == DEVICE_DISCONNECTED_C)
    {
        snprintf(
            message,
            sizeof(message),
            "%s: HIBA - homerseklet nem olvashato!",
            sensorName
        );

        logMessage(message);

        return;
    }


    snprintf(
        message,
        sizeof(message),
        "%s: %.2f C",
        sensorName,
        temperature
    );

    logMessage(message);
}

// Egyetlen DS18B20 hőmérsékletének kiolvasása systemData struktúrába
float readSensorTemperature(const char* sensorAddress)
{
    DeviceAddress address;

    // Cím átalakítás
    if (!stringToAddress(sensorAddress, address))
    {
        return NAN;
    }

    // Hőmérséklet kiolvasása
    float temperature = ds18b20.getTempC(address);

    // Első olvasás sikeres
    if (temperature != DEVICE_DISCONNECTED_C)
    {
        return temperature;
    }

    // Első olvasás hibás
    SensorReadStats* stats = nullptr;

    if (strcmp(sensorAddress, GAS_FLOW_SENSOR) == 0)
    {
        stats = &gasFlowStats;
    }
    else if (strcmp(sensorAddress, GAS_RETURN_SENSOR) == 0)
    {
        stats = &gasReturnStats;
    }
    else if (strcmp(sensorAddress, WOOD_FLOW_SENSOR) == 0)
    {
        stats = &woodFlowStats;
    }
    else if (strcmp(sensorAddress, WOOD_RETURN_SENSOR) == 0)
    {
        stats = &woodReturnStats;
    }
    else if (strcmp(sensorAddress, WOOD_BOILER_SENSOR) == 0)
    {
        stats = &woodBoilerStats;
    }

    if (stats != nullptr)
    {
        stats->firstReadError++;
    }

    // 10 ms várakozás
    delay(10);

    // Újraolvasás
    temperature = ds18b20.getTempC(address);

    // Újraolvasás sikeres
    if (temperature != DEVICE_DISCONNECTED_C)
    {
        if (stats != nullptr)
        {
            stats->retrySuccess++;
        }

        return temperature;
    }

    // Mindkét olvasás hibás
    if (stats != nullptr)
    {
        stats->doubleError++;
    }

    return NAN;
}

void ds18b20Setup()
{
    ds18b20.begin();

    logMessage("DS18B20 OneWire busz inicializalva.");
}

void printSensorReadStats()
{
    char message[100];

    logMessage("");
    logMessage("================================");
    logMessage("DS18B20 OLVASASI STATISZTIKA");
    logMessage("================================");

    snprintf(
        message,
        sizeof(message),
        "GAS_FLOW: elso hiba=%lu, retry siker=%lu, dupla hiba=%lu",
        gasFlowStats.firstReadError,
        gasFlowStats.retrySuccess,
        gasFlowStats.doubleError
    );
    logMessage(message);

    snprintf(
        message,
        sizeof(message),
        "GAS_RETURN: elso hiba=%lu, retry siker=%lu, dupla hiba=%lu",
        gasReturnStats.firstReadError,
        gasReturnStats.retrySuccess,
        gasReturnStats.doubleError
    );
    logMessage(message);

    snprintf(
        message,
        sizeof(message),
        "WOOD_FLOW: elso hiba=%lu, retry siker=%lu, dupla hiba=%lu",
        woodFlowStats.firstReadError,
        woodFlowStats.retrySuccess,
        woodFlowStats.doubleError
    );
    logMessage(message);

    snprintf(
        message,
        sizeof(message),
        "WOOD_RETURN: elso hiba=%lu, retry siker=%lu, dupla hiba=%lu",
        woodReturnStats.firstReadError,
        woodReturnStats.retrySuccess,
        woodReturnStats.doubleError
    );
    logMessage(message);

    snprintf(
        message,
        sizeof(message),
        "WOOD_BOILER: elso hiba=%lu, retry siker=%lu, dupla hiba=%lu",
        woodBoilerStats.firstReadError,
        woodBoilerStats.retrySuccess,
        woodBoilerStats.doubleError
    );
    logMessage(message);

    logMessage("================================");
}

unsigned long sensorStatsPrintTime = 0;

void updateSensorReadStats()
{
    if (millis() - sensorStatsPrintTime < 60000)
    {
        return;
    }

    sensorStatsPrintTime = millis();

    printSensorReadStats();
}

void ds18b20Scan()
{
    logMessage("");
    logMessage("================================");
    logMessage("DS18B20 SZENZOR TESZT INDUL");
    logMessage("================================");


    int deviceCount = ds18b20.getDeviceCount();

    char message[100];

    snprintf(
        message,
        sizeof(message),
        "Talalt eszkozok szama: %d",
        deviceCount
    );

    logMessage(message);


    if (deviceCount != 5)
    {
        snprintf(
            message,
            sizeof(message),
            "FIGYELEM: 5 szenzor vart, de %d talalva!",
            deviceCount
        );

        logMessage(message);
    }


    // Minden DS18B20 egyszerre megkezdi a mérést
    ds18b20.requestTemperatures();


    logMessage("--------------------");


    readSensor(
        "GAS_FLOW_SENSOR",
        GAS_FLOW_SENSOR
    );

    readSensor(
        "GAS_RETURN_SENSOR",
        GAS_RETURN_SENSOR
    );

    readSensor(
        "WOOD_FLOW_SENSOR",
        WOOD_FLOW_SENSOR
    );

    readSensor(
        "WOOD_RETURN_SENSOR",
        WOOD_RETURN_SENSOR
    );

    readSensor(
        "WOOD_BOILER_SENSOR",
        WOOD_BOILER_SENSOR
    );

    printSensorReadStats();

    logMessage("================================");
    logMessage("DS18B20 SZENZOR TESZT VEGE");
    logMessage("================================");
}
