AttilaFiel/Heating_Monitor_System/Firmware/Display/include/display.h

#pragma once
#include "system_data.h"
void displayBegin();
void displayMessage(const String &title, const String &message);
void displayUpdate(const MasterData &m, const LocalData &l, const KidsThermometerData &kids);
