AttilaFiel/Heating_Monitor_System/Firmware/Master/include/rtc.h

#pragma once

#include <RTClib.h>

extern RTC_DS3231 rtc;

void rtcSetup();
void rtcUpdate();
bool rtcIsAvailable();
void rtcTest();
bool rtcBatteryWarning();
bool rtcOscillatorStopWarning();

DateTime rtcNowLocal();
