AttilaFiel/Heating_Monitor_System/Firmware/Master/Heating_Monitor_System/include/sd_card.h

#pragma once

void sdCardSetup();
void sdCardTest();

void sdCardUpdate();
bool sdCardIsAvailable();
bool sdCardIsFull();
bool sdCardHasWarning();

bool sdCardIsBusy();
void sdCardSetBusy(bool busy);

void sdCardWriteError(const char* reason);
