AttilaFiel/Heating_Monitor_System/(commit log)

2026-08-03 Initial project and custom ESP32-DEVKITC-32UE symbol
    [HMS_Master.kicad_pcb, HMS_Master.kicad_sch]
2026-08-03 Create power supply block and clean ERC
    [HMS_Master.kicad_sch]
2026-08-03 Insert symbol file into git commit
2026-08-05 Schematic Complete
    [01_ESP32.kicad_sch, 02_Power_Supply.kicad_sch, 03_Display.kicad_sch, 04_Chimney_Temperature.kicad_sch, 05_Temperature_Sensors.kicad_sch, 06_RTC.kicad_sch, 07_Buzzer.kicad_sch, 08_Boiler_Room_Sensor.kicad_sch]
2026-08-05 Cleared deleted sheet file
    [08_Relays.kicad_sch]
2026-08-05 Footprints are created and assigned
    [02_Power_Supply.kicad_sch, 03_Display.kicad_sch, 04_Chimney_Temperature.kicad_sch, 05_Temperature_Sensors.kicad_sch, 06_RTC.kicad_sch, 07_Buzzer.kicad_sch, 08_Boiler_Room_Sensor.kicad_sch, 09_MicroSD.kicad_sch]
2026-08-07 LEDs sheet added, schematic finished
    [01_ESP32.kicad_sch, 02_Power_Supply.kicad_sch, 03_Display.kicad_sch, 04_Chimney_Temperature.kicad_sch, 05_Temperature_Sensors.kicad_sch, 06_RTC.kicad_sch, 07_Buzzer.kicad_sch, 08_Boiler_Room_Sensor.kicad_sch]
2026-08-16 Finished PCB
    [01_ESP32.kicad_sch, 02_Power_Supply.kicad_sch, 03_Display.kicad_sch, 05_Temperature_Sensors.kicad_sch, 07_Buzzer.kicad_sch, 08_Boiler_Room_Sensor.kicad_sch, 10_Voltage_Detectors.kicad_sch, 11_LEDs.kicad_sch]
2026-08-18 Finished Boiler room schematic
    [HMS_230V.kicad_pcb, HMS_230V.kicad_sch]
2026-08-18 Schematic printouts
    [HMS_230V.kicad_sch]
2026-08-25 First version of the firmware. Over-The-Air Update, Wifi terminal read, RGB LED test
2026-08-27 Firmware test for all sensors. HMS_230V AC present sensor wire fix
    [ac_sensor.cpp, config.h, dht11.cpp, ds18b20.cpp, ds18b20.h, i2c_scanner.cpp]
2026-08-30 Sensor manager and data manager finalization
    [HMS_230V.kicad_sch]
2026-09-01 230V connection schematic polishing
    [HMS_230V.kicad_sch]
2026-09-07 Buzzer allert and LED control
    [buzzer.cpp, config.h, data_manager.cpp, data_manager.h, display.cpp, logger.cpp, logger.h]
2026-09-18 Handle DS18B20 sensors reading errors
    [config.h, ds18b20.cpp, ds18b20.h, main.cpp, network.cpp, sensor_manager.cpp]
2026-09-18 Thermostat switch AC sensor grace time fix
    [data_manager.cpp]
2026-09-23 Webpage download watchdog fix and data show
    [logger.cpp, max6675.cpp, network.cpp]
2026-09-23 DS18B20 sensor address fix and HMS_230V sch in progress
    [HMS_230V.kicad_sch]
2026-10-05 RGB led config switch
2026-10-06 Network security fix and comment translate
    [config.h, data_manager.cpp, display.cpp, main.cpp, sensor_manager.cpp]
2026-10-08 DS18B20 sensors error warning finished before testing
    [data_manager.cpp, sd_card.cpp, sensor_manager.cpp, system_data.h]
2026-10-08 MAX6675 and DHT11 sensors error warning finished
    [sensor_manager.cpp]
2026-10-08 Keep temperature value on display in case of sensor error
    [display.cpp]
2026-10-09 Boiler overheat test deploy
    [boiler_overheat_test.cpp, config.h, main.cpp]
2026-10-11 HTTP api contract and apis created for monitoring (buzzer switch implemented)
2026-10-11 MAX6675 too much log fix, logMessage() on/off switch implementation
2026-10-12 Refactor KiCad Master directory structure
2026-10-12 HMS_Display new KiCad project created
2026-10-28 HMS_Diaply Kicad schematics and PCB
2026-10-28 HMS_Diaply KiCad footprints and symbol
2026-10-30 HMS_Diaply temperature correction apllied
